pridolfi/lisa32/README.md

# LISA32

An ESP32 development board with both UART and JTAG interfaces.

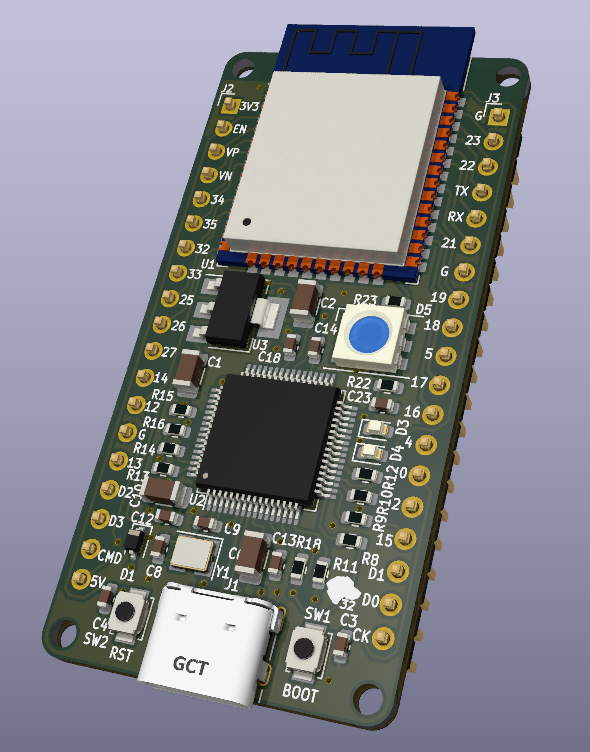
[picture p1: doc/lisa32_v0.1.1.png]
lisa32 image


## v0.1.0 prototype

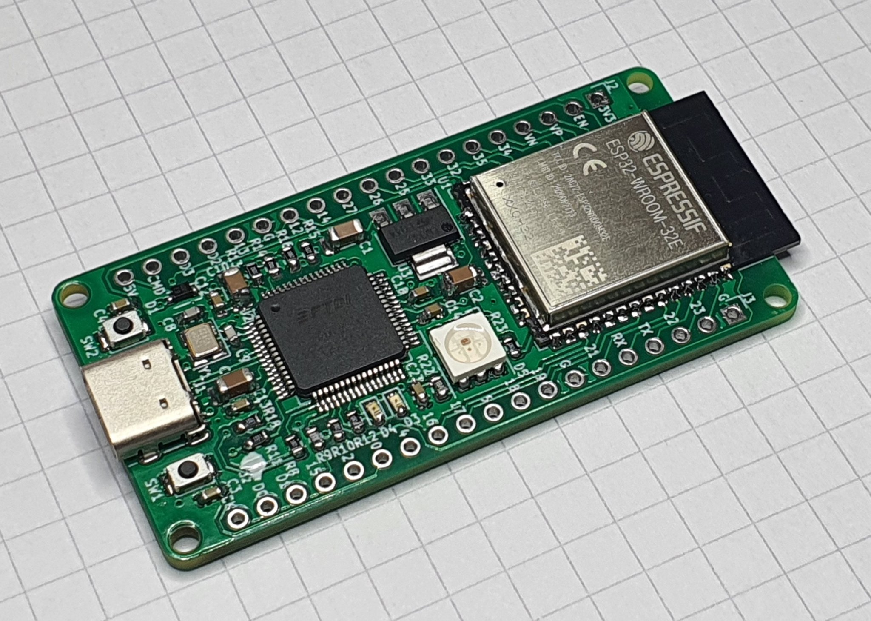
[picture p2: doc/lisa32_v0.1.0.jpeg]
lisa32 image
