pridolfi/lisa32/doc/front.png

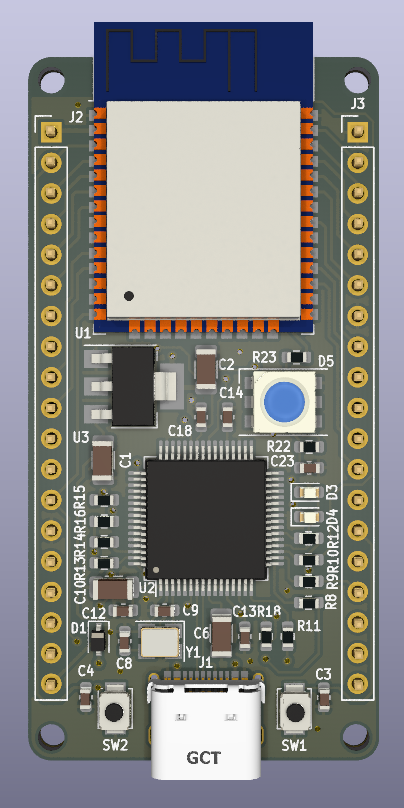
doc/front.png
