pridolfi/lisa32/3d/GCT_-_USB4105-GF-A.step

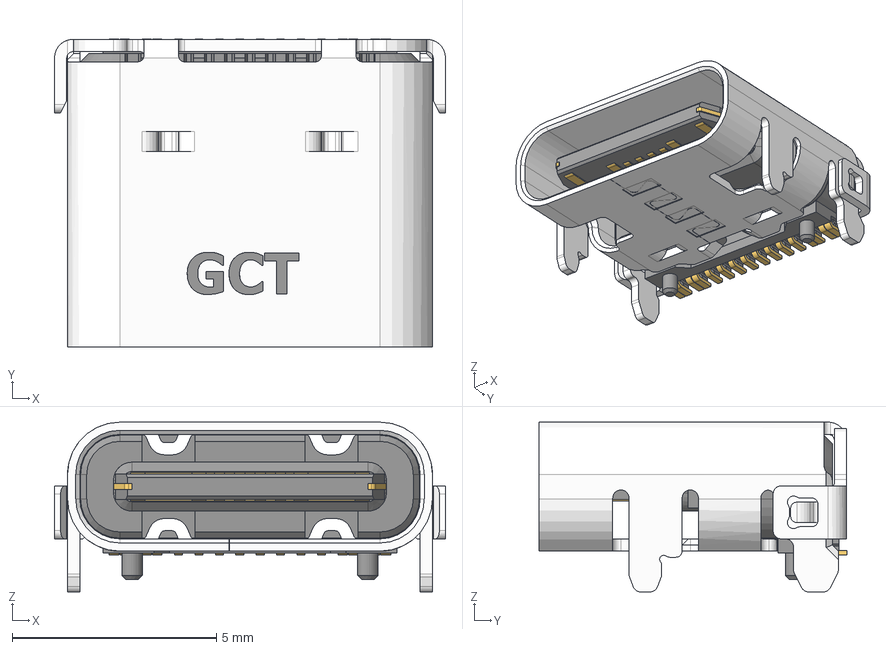
[picture p4: CAD file, 2021-01-06]
3d/GCT_-_USB4105-GF-A.step
9.58 x 7.53 x 4.16 mm
USB4105-15-A_PART2
1_MIR
GCT
