pridolfi/lisa32/doc/lisa32.pdf

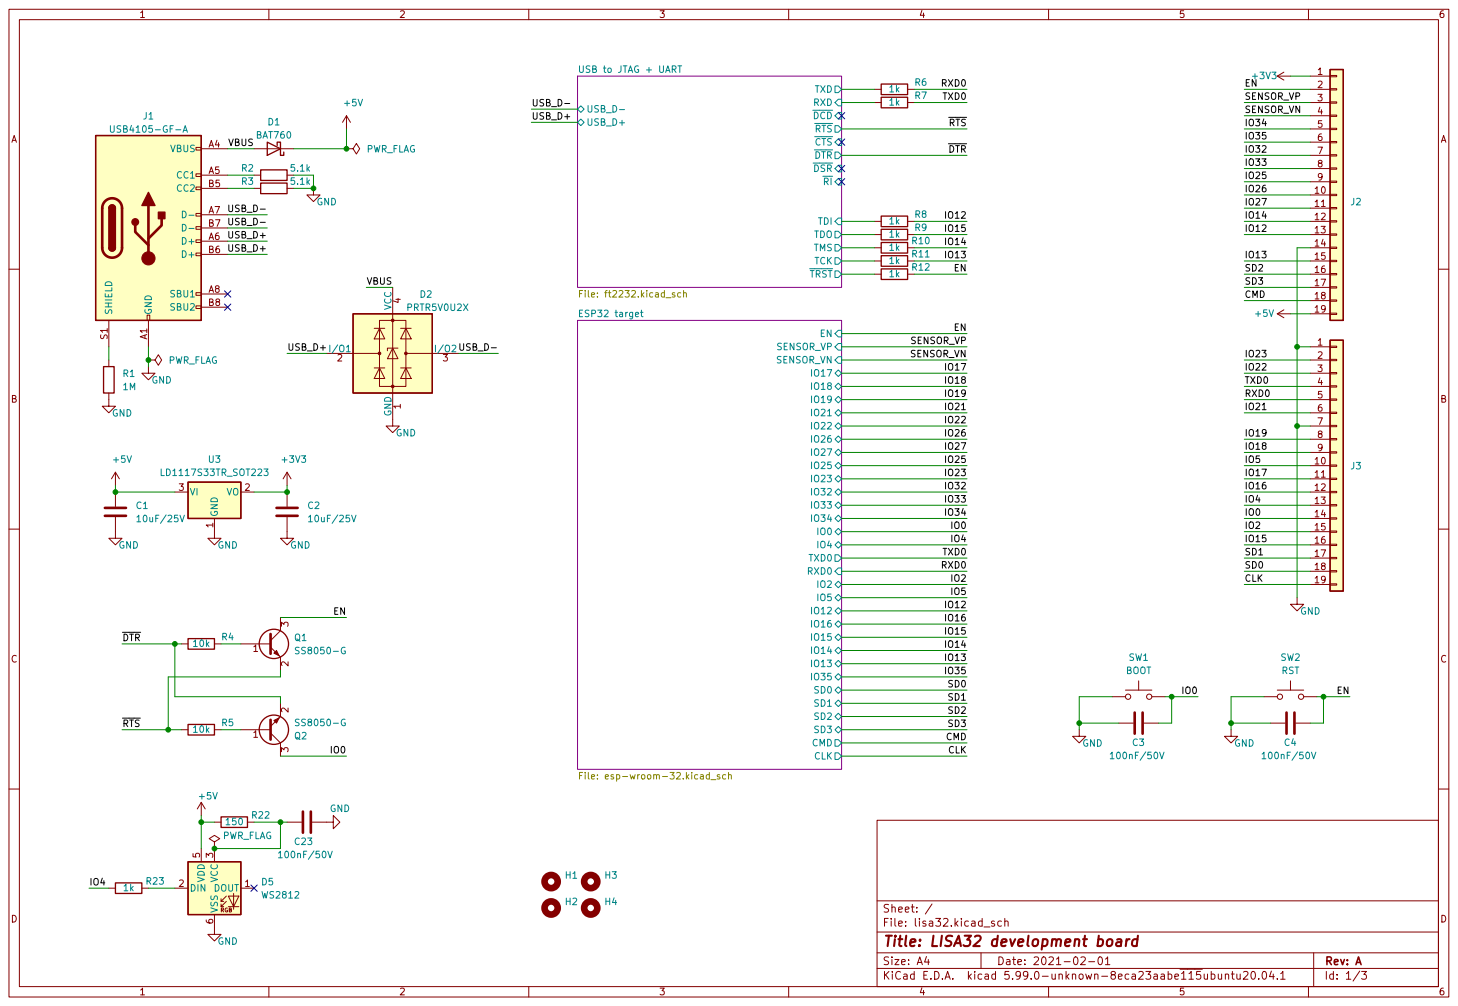
[picture p5: page 1]

USB to JTAG + UART

File: lisa32.kicad_sch Sheet: /
Id: 1/3 Title: LISA32 development board

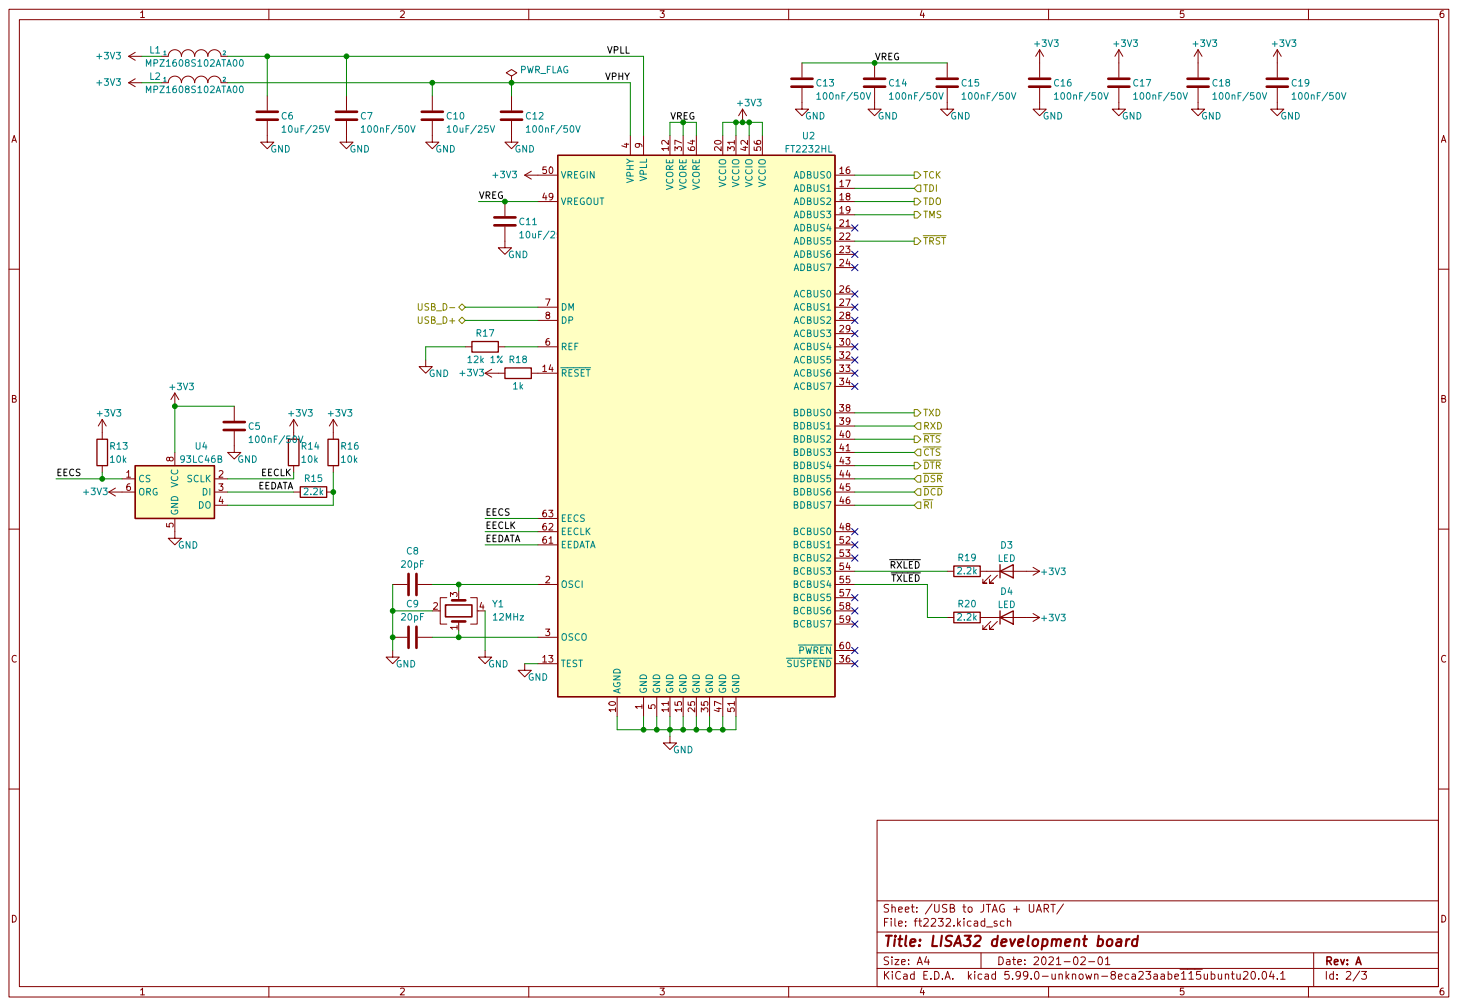
[picture p6: page 2]

1 AGND 10 GND 11 VCORE 12 TEST 13 ~RESET 14 GND 15 ADBUS0 16 ADBUS1 17 ADBUS2 18 ADBUS3 19 OSCI 2 VCCIO 20 ADBUS4 21 ADBUS5 22 ADBUS6 23 ADBUS7 24 GND 25 ACBUS0 26 ACBUS1 27 ACBUS2 28 ACBUS3 29 OSCO 3 ACBUS4 30 VCCIO 31 ACBUS5 32 ACBUS6 33 ACBUS7 34 GND 35 ~SUSPEND 36 VCORE 37 BDBUS0 38 BDBUS1 39 VPHY

4 BDBUS2 40 BDBUS3 41 VCCIO 42 BDBUS4 43 BDBUS5 44 BDBUS6 45 BDBUS7 46 GND 47 BCBUS0 48 VREGOUT 49 GND

5 VREGIN 50 GND 51 BCBUS1 52 BCBUS2 53 BCBUS3 54 BCBUS4 55 VCCIO 56 BCBUS5 57 BCBUS6 58 BCBUS7 59 REF 6 ~PWREN 60 EEDATA 61 EECLK 62 EECS 63 VCORE 64 DM 7 DP 8 VPLL

File: ft2232.kicad_sch Sheet: /USB to JTAG + UART/
Id: 2/3 Title: LISA32 development board

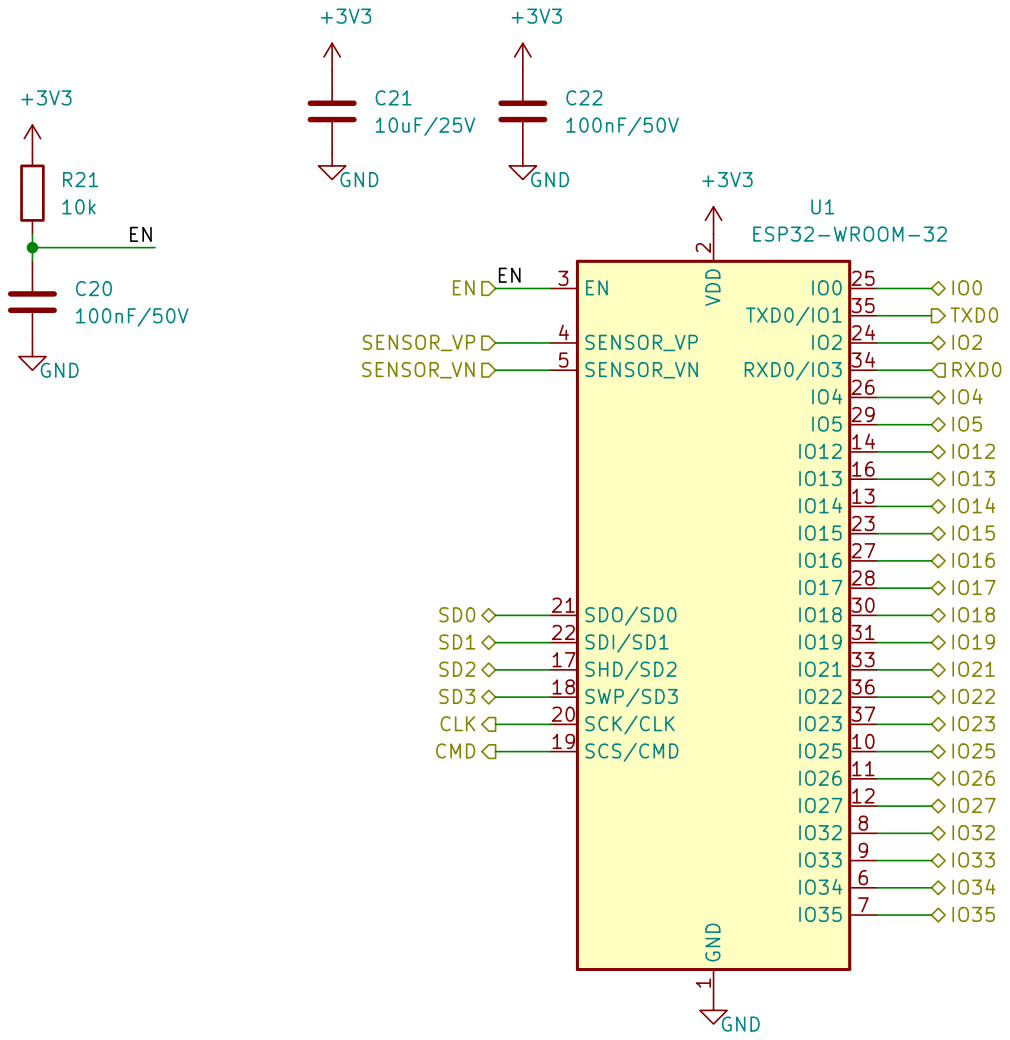
[picture p7: page 3]

2 SCK/CLK 20 SDO/SD0 21 SDI/SD1 22

Sheet: /ESP32 target/
File: esp-wroom-32.kicad_sch
Id: 3/3 Title: LISA32 development board
