pridolfi/lisa32/lisa32.kicad_pcb

## KiCad design lisa32.kicad_pcb (2021-02-01)

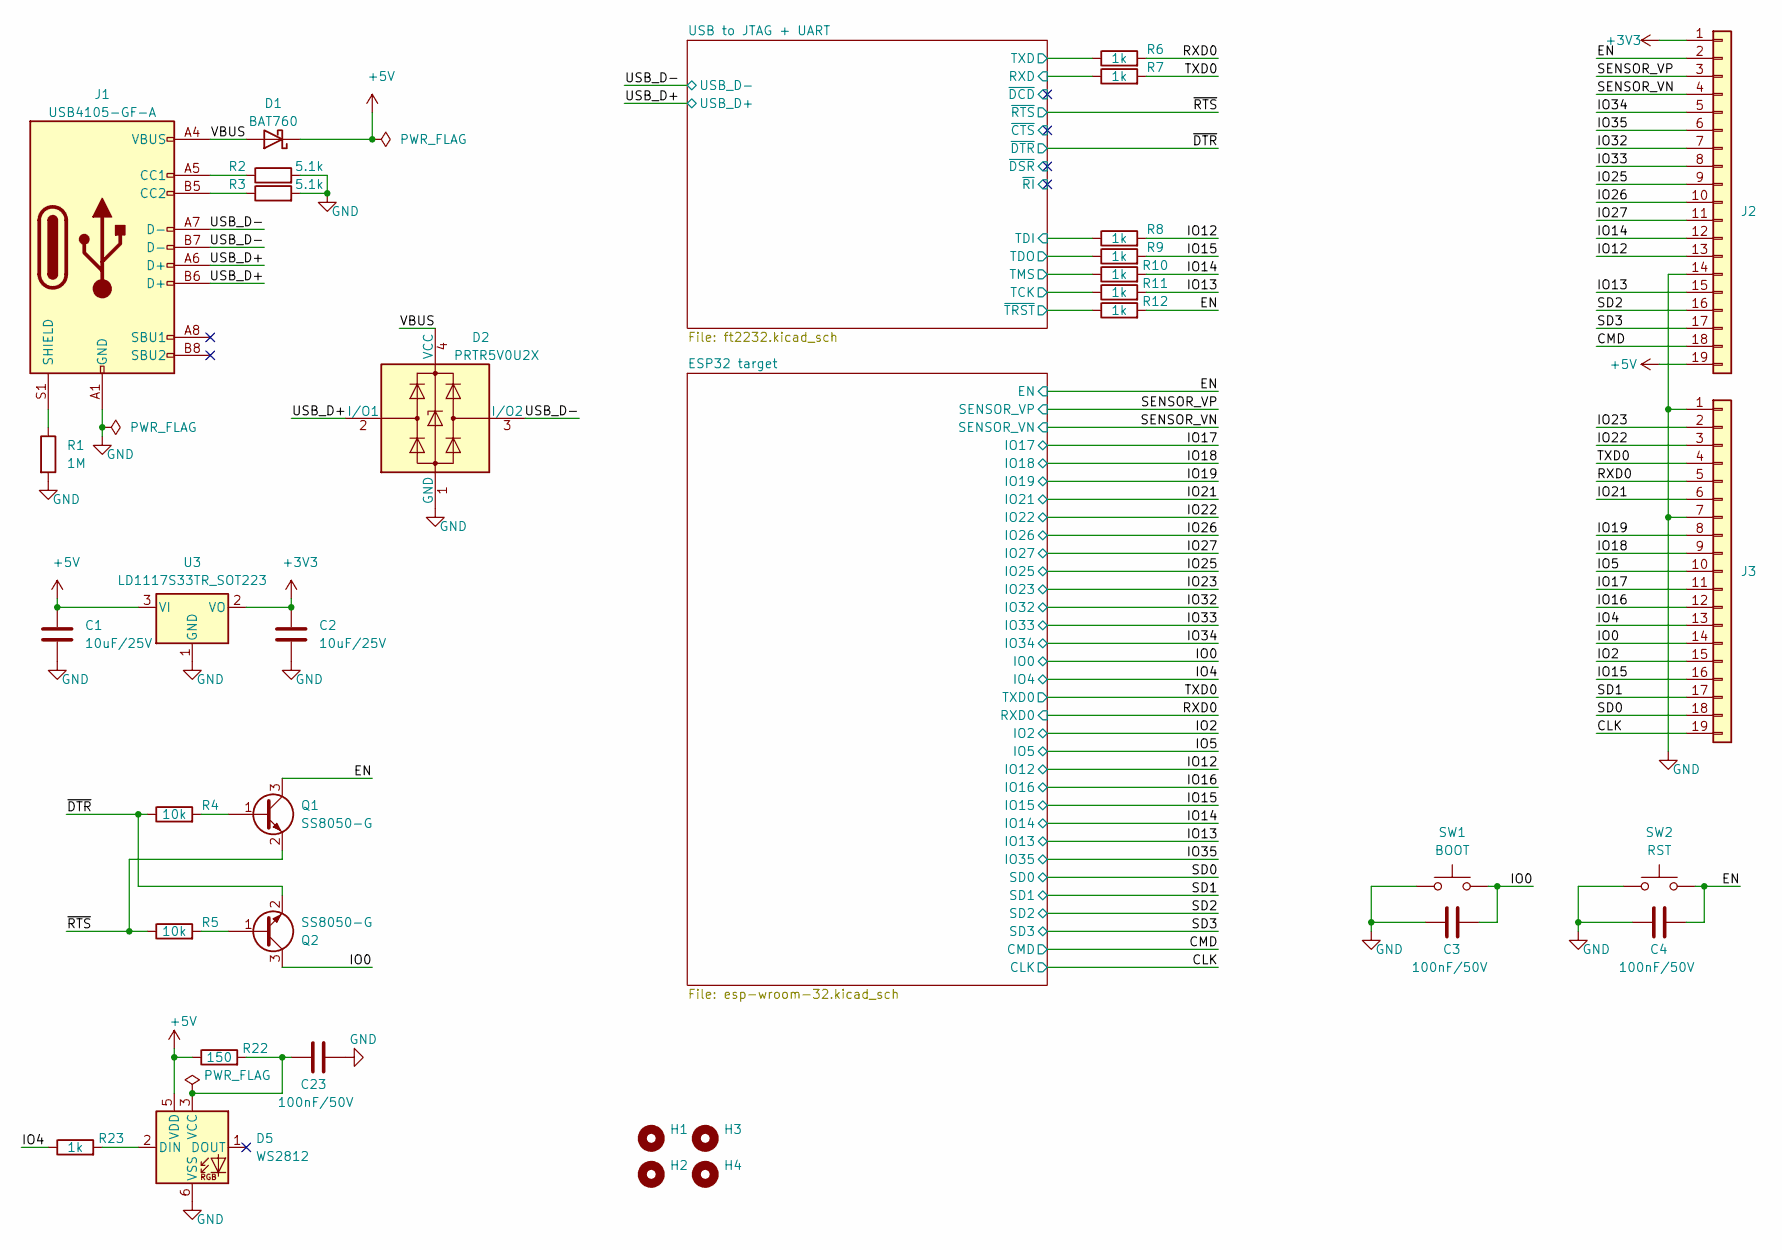
[picture p8: schematic lisa32.kicad_sch, LISA32 development board]

Parts:
C1, C2: 10uF/25V; C_1206_3216Metric
C3, C4, C23: 100nF/50V; C_0603_1608Metric
D1: BAT760; D_SOD-323
D2: PRTR5V0U2X; SOT-143
D5: WS2812; LED_WS2812_PLCC6_5.0x5.0mm_P1.6mm
H1, H2, H3, H4: MountingHole; MountingHole_2.2mm_M2
J1: USB4105-GF-A; USB_C_Receptacle_Palconn_UTC16-G
J2, J3: Conn_01x19; PinHeader_1x19_P2.54mm_Vertical
Q1, Q2: SS8050-G; SOT-23
R1: 1M; R_0603_1608Metric
R2, R3: 5.1k; R_0603_1608Metric
R4, R5: 10k; R_0603_1608Metric
R6, R7, R8, R9, R10, R11, R12, R23: 1k; R_0603_1608Metric
R22: 150; R_0603_1608Metric
SW1: BOOT; SW_SPST_B3U-1000P
SW2: RST; SW_SPST_B3U-1000P
U3: LD1117S33TR_SOT223; SOT-223-3_TabPin2

Connections:
+3V3: C2.1, J2.1, U3.2 (VO); also elsewhere on the board
+5V: C1.1, D1.1 (K), D5.5 (VDD), J2.19, R22.1, U3.3 (VI)
/CLK: J3.19; also elsewhere on the board
/CMD: J2.18; also elsewhere on the board
/EN: C4.2, J2.2, Q1.3 (C), R12.2, SW2.2; also elsewhere on the board
/IO0: C3.2, J3.14, Q2.3 (C), SW1.2; also elsewhere on the board
/IO2: J3.15; also elsewhere on the board
/IO4: J3.13, R23.1; also elsewhere on the board
/IO5: J3.10; also elsewhere on the board
/IO12: J2.13, R8.2; also elsewhere on the board
/IO13: J2.15, R11.2; also elsewhere on the board
/IO14: J2.12, R10.2; also elsewhere on the board
/IO15: J3.16, R9.2; also elsewhere on the board
/IO16: J3.12; also elsewhere on the board
/IO17: J3.11; also elsewhere on the board
/IO18: J3.9; also elsewhere on the board
/IO19: J3.8; also elsewhere on the board
/IO21: J3.6; also elsewhere on the board
/IO22: J3.3; also elsewhere on the board
/IO23: J3.2; also elsewhere on the board
/IO25: J2.9; also elsewhere on the board
/IO26: J2.10; also elsewhere on the board
/IO27: J2.11; also elsewhere on the board
/IO32: J2.7; also elsewhere on the board
/IO33: J2.8; also elsewhere on the board
/IO34: J2.5; also elsewhere on the board
/IO35: J2.6; also elsewhere on the board
/RXD: R7.1; also elsewhere on the board
/RXD0: J3.5, R6.2; also elsewhere on the board
/SD0: J3.18; also elsewhere on the board
/SD1: J3.17; also elsewhere on the board
/SD2: J2.16; also elsewhere on the board
/SD3: J2.17; also elsewhere on the board
/SENSOR_VN: J2.4; also elsewhere on the board
/SENSOR_VP: J2.3; also elsewhere on the board
/TCK: R11.1; also elsewhere on the board
/TDI: R8.1; also elsewhere on the board
/TDO: R9.1; also elsewhere on the board
/TMS: R10.1; also elsewhere on the board
/TXD: R6.1; also elsewhere on the board
/TXD0: J3.4, R7.2; also elsewhere on the board
/USB_D+: D2.2 (I/O1), J1.A6 (D+), J1.B6 (D+); also elsewhere on the board
/USB_D-: D2.3 (I/O2), J1.A7 (D-), J1.B7 (D-); also elsewhere on the board
/VBUS: D1.2 (A), D2.4 (VCC), J1.A4 (VBUS), J1.A9 (VBUS), J1.B4 (VBUS), J1.B9 (VBUS)
/~DTR: Q2.2 (E), R4.1; also elsewhere on the board
/~RTS: Q1.2 (E), R5.1; also elsewhere on the board
/~TRST: R12.1; also elsewhere on the board
GND: C1.2, C2.2, C3.1, C4.1, C23.2, D2.1 (GND), D5.6 (VSS), J1.A1 (GND), J1.A12 (GND), J1.B1 (GND), J1.B12 (GND), J2.14, J3.1, J3.7, R1.2, R2.2, R3.2, SW1.1, SW2.1, U3.1 (GND); also elsewhere on the board
unnamed: C23.1, D5.3 (VCC), R22.2
unnamed: D5.2 (DIN), R23.2
unnamed: J1.A5 (CC1), R2.1
unnamed: J1.B5 (CC2), R3.1
unnamed: J1.S1 (SHIELD), R1.1
unnamed: Q1.1 (B), R4.2
unnamed: Q2.1 (B), R5.2
no_connect_75: D5.1 (DOUT)
no_connect_76: J1.A8 (SBU1)
no_connect_77: J1.B8 (SBU2)

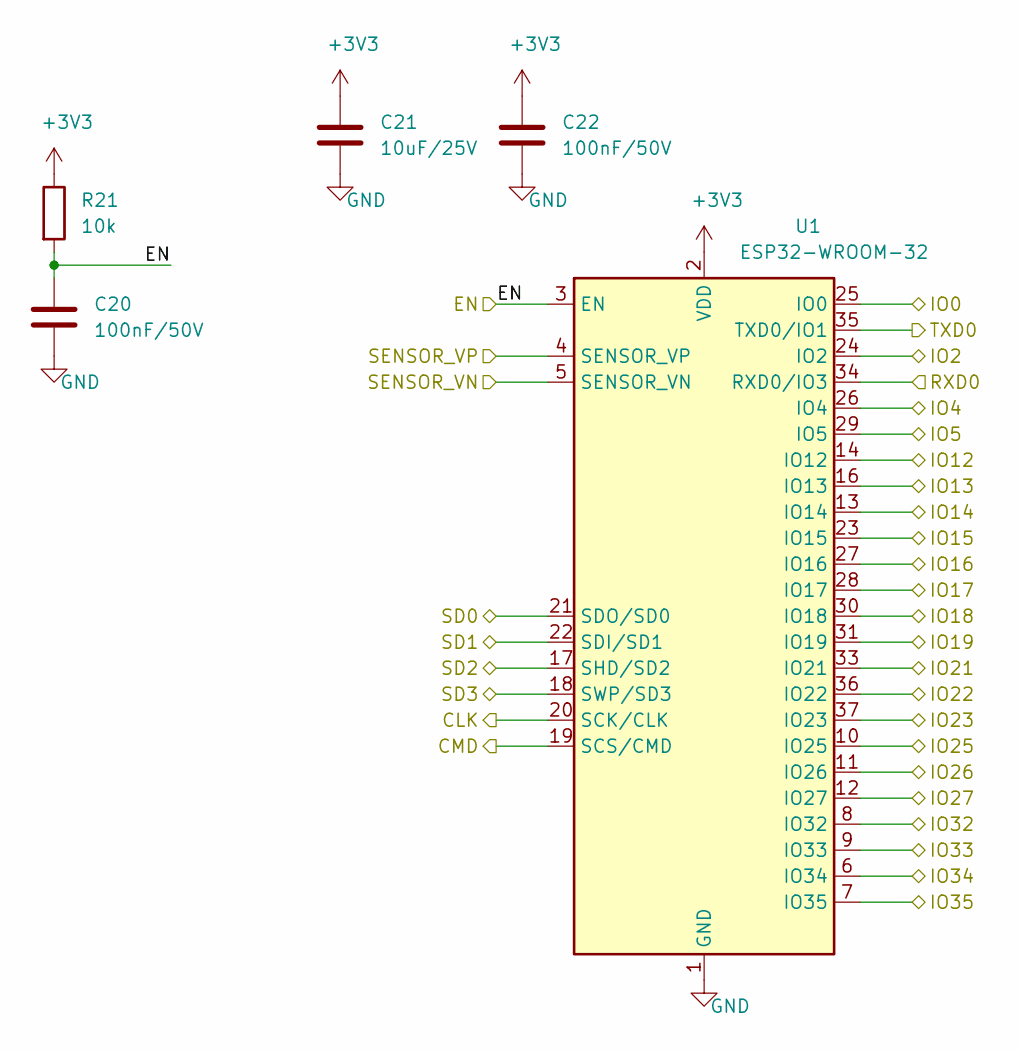
[picture p9: schematic esp-wroom-32.kicad_sch, LISA32 development board]

Parts:
C20, C22: 100nF/50V; C_0603_1608Metric
C21: 10uF/25V; C_1206_3216Metric
R21: 10k; R_0603_1608Metric
U1: ESP32-WROOM-32

Connections:
+3V3: C21.1, C22.1, R21.1, U1.2 (VDD); also elsewhere on the board
/CLK: U1.20 (SCK/CLK); also elsewhere on the board
/CMD: U1.19 (SCS/CMD); also elsewhere on the board
/EN: C20.1, R21.2, U1.3 (EN); also elsewhere on the board
/IO0: U1.25 (IO0); also elsewhere on the board
/IO2: U1.24 (IO2); also elsewhere on the board
/IO4: U1.26 (IO4); also elsewhere on the board
/IO5: U1.29 (IO5); also elsewhere on the board
/IO12: U1.14 (IO12); also elsewhere on the board
/IO13: U1.16 (IO13); also elsewhere on the board
/IO14: U1.13 (IO14); also elsewhere on the board
/IO15: U1.23 (IO15); also elsewhere on the board
/IO16: U1.27 (IO16); also elsewhere on the board
/IO17: U1.28 (IO17); also elsewhere on the board
/IO18: U1.30 (IO18); also elsewhere on the board
/IO19: U1.31 (IO19); also elsewhere on the board
/IO21: U1.33 (IO21); also elsewhere on the board
/IO22: U1.36 (IO22); also elsewhere on the board
/IO23: U1.37 (IO23); also elsewhere on the board
/IO25: U1.10 (IO25); also elsewhere on the board
/IO26: U1.11 (IO26); also elsewhere on the board
/IO27: U1.12 (IO27); also elsewhere on the board
/IO32: U1.8 (IO32); also elsewhere on the board
/IO33: U1.9 (IO33); also elsewhere on the board
/IO34: U1.6 (IO34); also elsewhere on the board
/IO35: U1.7 (IO35); also elsewhere on the board
/RXD0: U1.34 (RXD0/IO3); also elsewhere on the board
/SD0: U1.21 (SDO/SD0); also elsewhere on the board
/SD1: U1.22 (SDI/SD1); also elsewhere on the board
/SD2: U1.17 (SHD/SD2); also elsewhere on the board
/SD3: U1.18 (SWP/SD3); also elsewhere on the board
/SENSOR_VN: U1.5 (SENSOR_VN); also elsewhere on the board
/SENSOR_VP: U1.4 (SENSOR_VP); also elsewhere on the board
/TXD0: U1.35 (TXD0/IO1); also elsewhere on the board
GND: C20.2, C21.2, C22.2, U1.1 (GND), U1.15 (GND), U1.38 (GND), U1.39 (GND); also elsewhere on the board

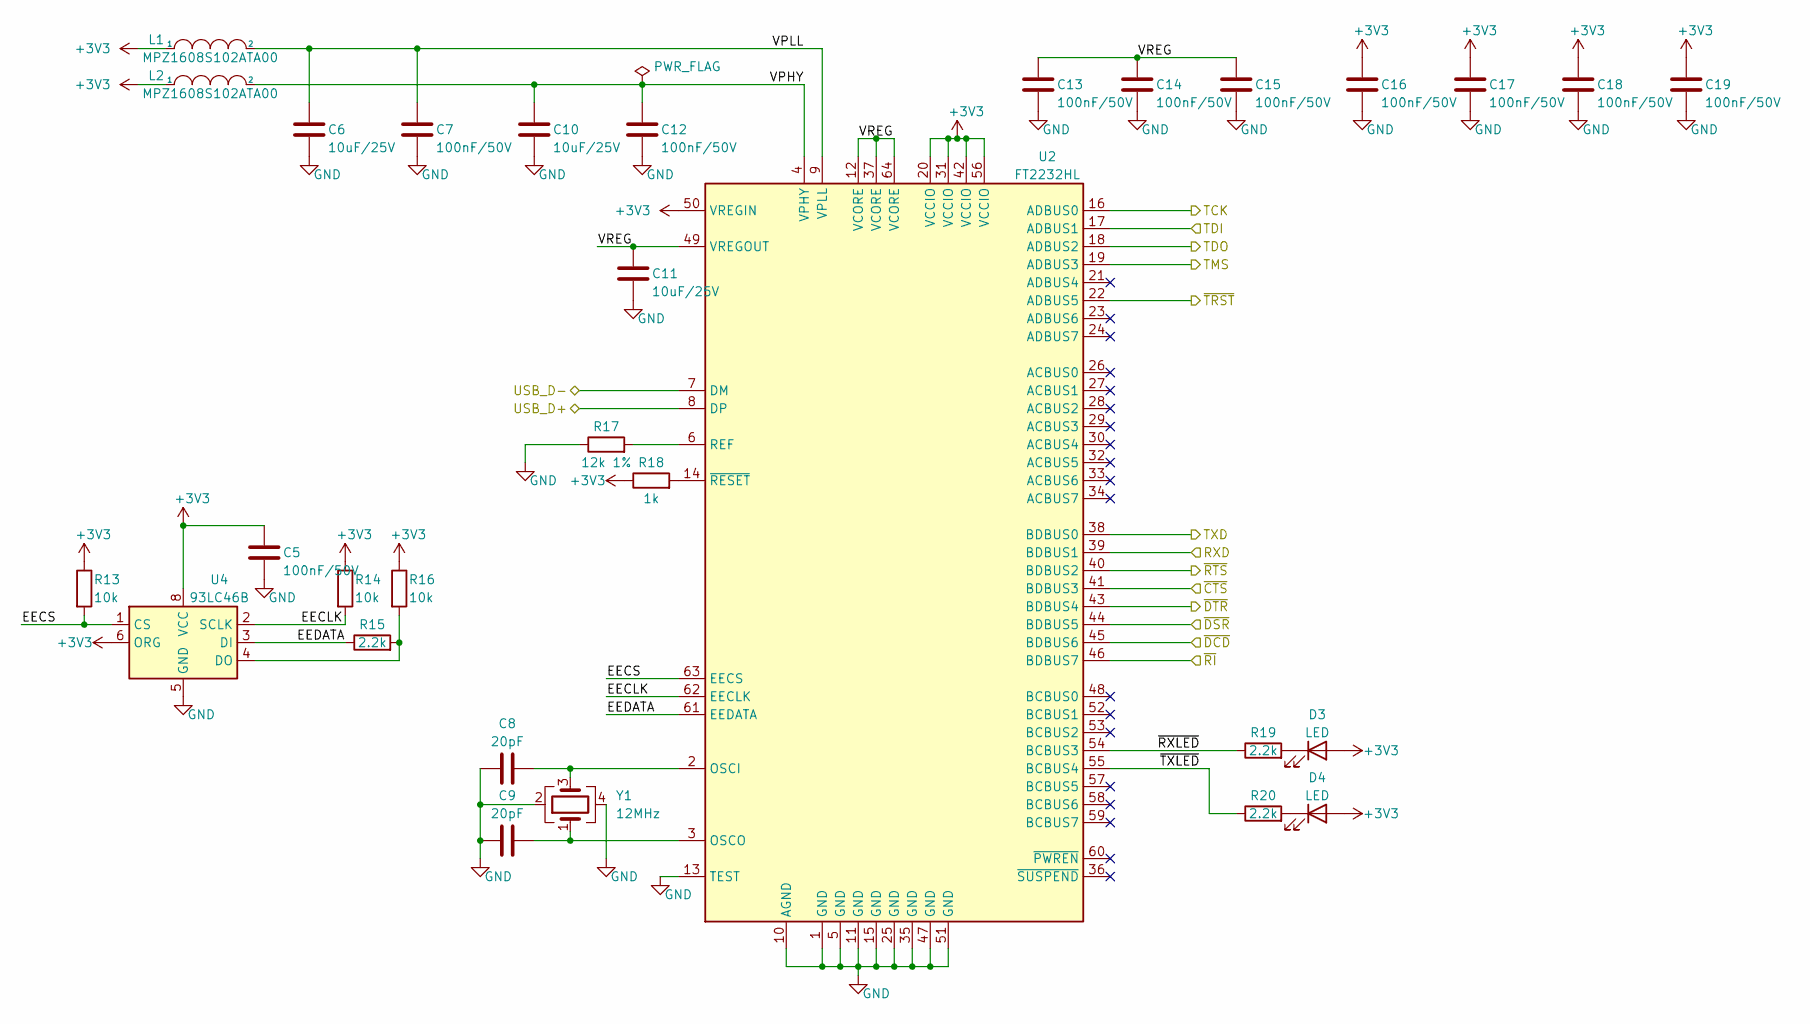
[picture p10: schematic ft2232.kicad_sch, LISA32 development board]

Parts:
C5, C7, C12, C13, C14, C15, C16, C17, C18, C19: 100nF/50V; C_0603_1608Metric
C6, C10, C11: 10uF/25V; C_1206_3216Metric
C8, C9: 20pF; C_0603_1608Metric
D3, D4: LED; LED_0603_1608Metric
L1, L2: MPZ1608S102ATA00; L_0603_1608Metric
R13, R14, R16: 10k; R_0603_1608Metric
R15, R19, R20: 2.2k; R_0603_1608Metric
R17: 12k 1%; R_0603_1608Metric
R18: 1k; R_0603_1608Metric
U2: FT2232HL; LQFP-64_10x10mm_P0.5mm
U4: 93LC46B; SO-8_3.9x4.9mm_P1.27mm
Y1: 12MHz; Crystal_SMD_3225-4Pin_3.2x2.5mm

Connections:
+3V3: C5.1, C16.1, C17.1, C18.1, C19.1, D3.2 (A), D4.2 (A), L1.1, L2.1, R13.1, R14.1, R16.1, R18.1, U2.20 (VCCIO), U2.31 (VCCIO), U2.42 (VCCIO), U2.50 (VREGIN), U2.56 (VCCIO), U4.6 (ORG), U4.8 (VCC); also elsewhere on the board
/RXD: U2.39 (BDBUS1); also elsewhere on the board
/TCK: U2.16 (ADBUS0); also elsewhere on the board
/TDI: U2.17 (ADBUS1); also elsewhere on the board
/TDO: U2.18 (ADBUS2); also elsewhere on the board
/TMS: U2.19 (ADBUS3); also elsewhere on the board
/TXD: U2.38 (BDBUS0); also elsewhere on the board
/USB to JTAG + UART/EECLK: R14.2, U2.62 (EECLK), U4.2 (SCLK)
/USB to JTAG + UART/EECS: R13.2, U2.63 (EECS), U4.1 (CS)
/USB to JTAG + UART/EEDATA: R15.1, U2.61 (EEDATA), U4.3 (DI)
/USB to JTAG + UART/VPHY: C10.1, C12.1, L2.2, U2.4 (VPHY)
/USB to JTAG + UART/VPLL: C6.1, C7.1, L1.2, U2.9 (VPLL)
/USB to JTAG + UART/VREG: C11.1, C13.1, C14.1, C15.1, U2.12 (VCORE), U2.37 (VCORE), U2.49 (VREGOUT), U2.64 (VCORE)
/USB to JTAG + UART/~RXLED: R19.1, U2.54 (BCBUS3)
/USB to JTAG + UART/~TXLED: R20.1, U2.55 (BCBUS4)
/USB_D+: U2.8 (DP); also elsewhere on the board
/USB_D-: U2.7 (DM); also elsewhere on the board
/~CTS: U2.41 (BDBUS3)
/~DCD: U2.45 (BDBUS6)
/~DSR: U2.44 (BDBUS5)
/~DTR: U2.43 (BDBUS4); also elsewhere on the board
/~RI: U2.46 (BDBUS7)
/~RTS: U2.40 (BDBUS2); also elsewhere on the board
/~TRST: U2.22 (ADBUS5); also elsewhere on the board
GND: C5.2, C6.2, C7.2, C8.1, C9.1, C10.2, C11.2, C12.2, C13.2, C14.2, C15.2, C16.2, C17.2, C18.2, C19.2, R17.1, U2.1 (GND), U2.5 (GND), U2.10 (AGND), U2.11 (GND), U2.13 (TEST), U2.15 (GND), U2.25 (GND), U2.35 (GND), U2.47 (GND), U2.51 (GND), U4.5 (GND), Y1.2, Y1.4; also elsewhere on the board
unnamed: C8.2, U2.2 (OSCI), Y1.3
unnamed: C9.2, U2.3 (OSCO), Y1.1
unnamed: D3.1 (K), R19.2
unnamed: D4.1 (K), R20.2
unnamed: R15.2, R16.2, U4.4 (DO)
unnamed: R17.2, U2.6 (REF)
unnamed: R18.2, U2.14 (~RESET)
no_connect_78: U2.21 (ADBUS4)
no_connect_79: U2.23 (ADBUS6)
no_connect_80: U2.24 (ADBUS7)
no_connect_81: U2.26 (ACBUS0)
no_connect_82: U2.27 (ACBUS1)
no_connect_83: U2.28 (ACBUS2)
no_connect_84: U2.29 (ACBUS3)
no_connect_85: U2.30 (ACBUS4)
no_connect_86: U2.32 (ACBUS5)
no_connect_87: U2.33 (ACBUS6)
no_connect_88: U2.34 (ACBUS7)
no_connect_89: U2.36 (~SUSPEND)
no_connect_90: U2.48 (BCBUS0)
no_connect_91: U2.52 (BCBUS1)
no_connect_92: U2.53 (BCBUS2)
no_connect_93: U2.57 (BCBUS5)
no_connect_94: U2.58 (BCBUS6)
no_connect_95: U2.59 (BCBUS7)
no_connect_96: U2.60 (~PWREN)

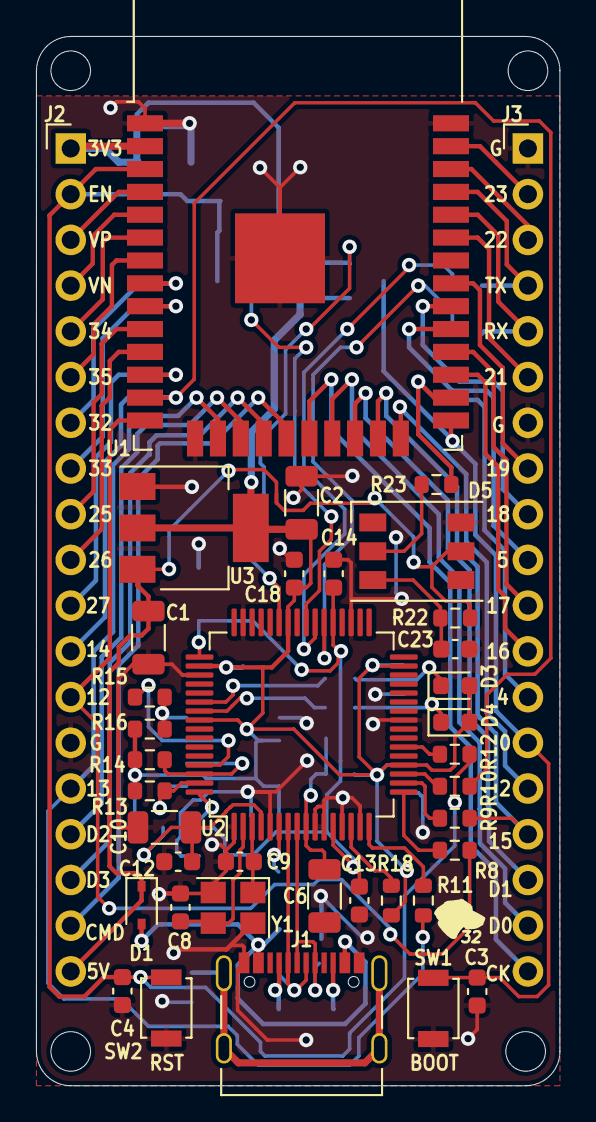
[picture p11: board lisa32.kicad_pcb from above]

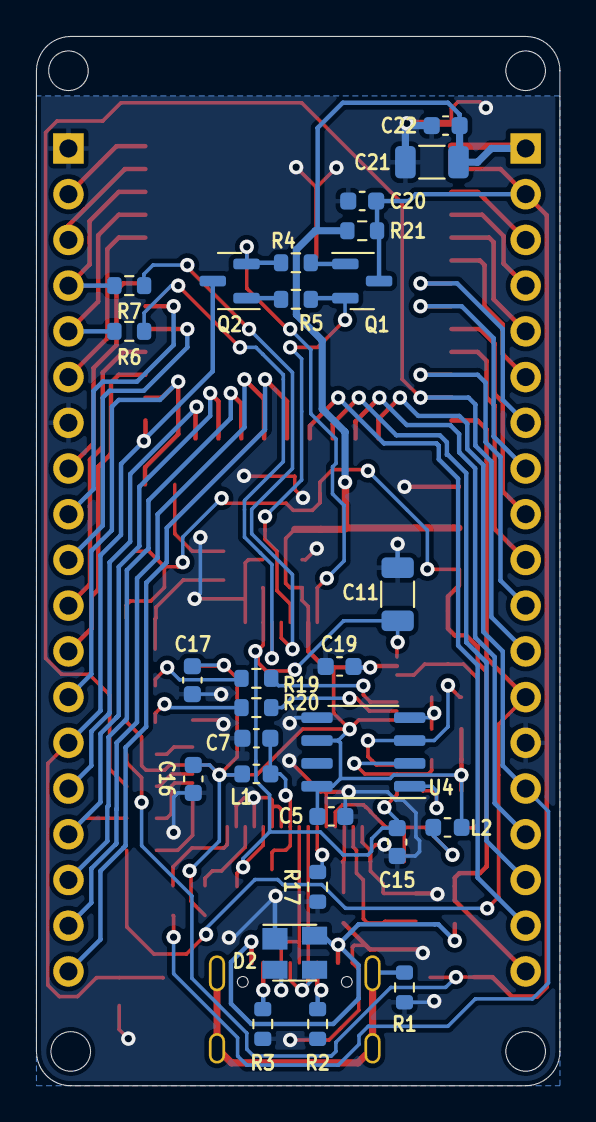
[picture p12: board lisa32.kicad_pcb from below]

Board: 2 copper layers, 29.1 x 58.3 mm, 69 parts (27 on the bottom side), 70 nets.
