pridolfi/lisa32/(commit log)

2020-12-31 sch wip
    [esp-wroom-32.kicad_sch, ft2232.kicad_sch, lisa32.kicad_pcb, lisa32.kicad_sch]
2020-12-31 erc ok
    [esp-wroom-32.kicad_sch, ft2232.kicad_sch, lisa32.kicad_sch]
2020-12-31 wip footprint assoc
    [esp-wroom-32.kicad_sch, ft2232.kicad_sch, lisa32.kicad_sch]
2021-01-01 placing test
    [esp-wroom-32.kicad_sch, ft2232.kicad_sch, lisa32.kicad_pcb, lisa32.kicad_sch]
2021-01-02 fix autoprogram signals
    [DX07S016JA1R1500--3DModel-STEP-56544.STEP, ft2232.kicad_sch, lisa32.kicad_pcb, lisa32.kicad_sch]
2021-01-02 sch update
    [esp-wroom-32.kicad_sch, ft2232.kicad_sch, lisa32.kicad_pcb, lisa32.kicad_sch]
2021-01-03 wip placing
    [ft2232.kicad_sch, lisa32.kicad_pcb, lisa32.kicad_sch]
2021-01-06 routing completed
    [DX07S016JA1R1500--3DModel-STEP-56544.STEP, GCT_-_USB4105-GF-A.step, ft2232.kicad_sch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]
2021-01-07 add PN
    [esp-wroom-32.kicad_sch, ft2232.kicad_sch, lisa32.kicad_sch]
2021-01-30 readme and button labels
    [lisa32.kicad_pcb]
2021-02-01 udpate bom and sch
    [LISA32_BOM.csv, esp-wroom-32.kicad_sch, ft2232.kicad_sch, lisa32.kicad_sch]
